sametgul/roman3d/docs/embedded_sw.md

# Roman3D: Embedded Software

## Overview

We used STM32CubeIDE to develop the embedded software. Here is Pinout View of the MCU.

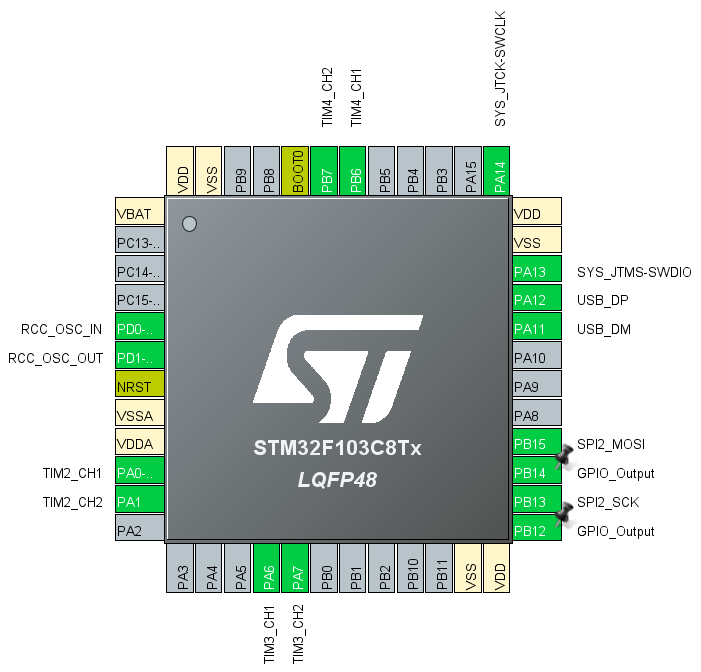
[picture p3: figs/pinoutstm32.png]
template


In pinout & configuration window, make sure you chose the following settings.

System Core -> GPIO

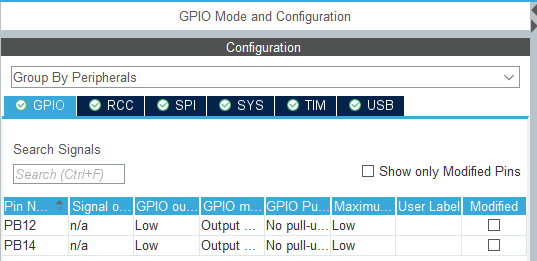
[picture p4: figs/gpiocube.png]
gpio


System Core -> RCC

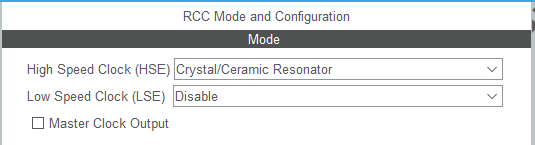
[picture p5: figs/rcccube.png]
rcc


System Core -> SYS

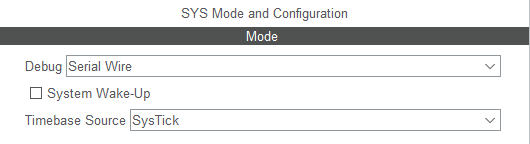
[picture p6: figs/syscube.png]
sys


We use Timers for Encoder reading. Timers -> TIM2, TIM3, TIM4

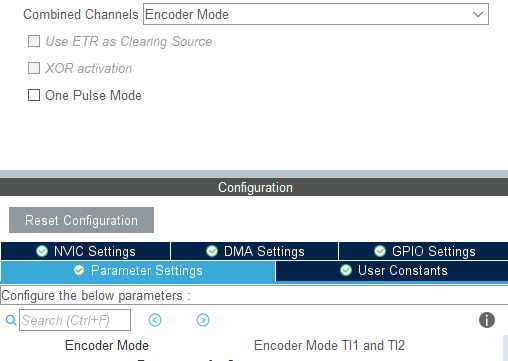
[picture p7: figs/tim234cube.png]
tim234


The SPI settings (Data Size and First Bit) chosen according to DAC chips datasheet. 

Connectivity -> SPI2

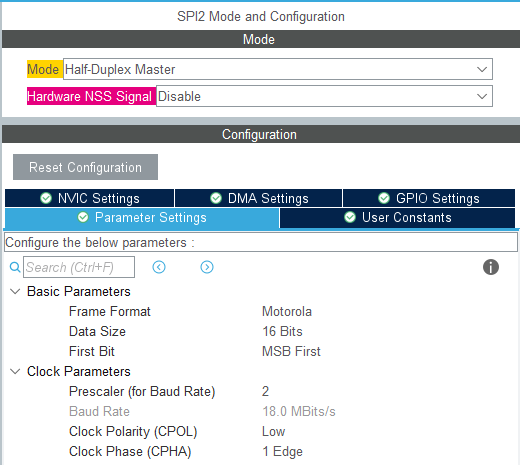
[picture p8: figs/spi2cube.png]
spi2


Connectivity -> USB

USB

Middleware -> USB_DEVICE

USB Dev

Here is Clock Configurtion

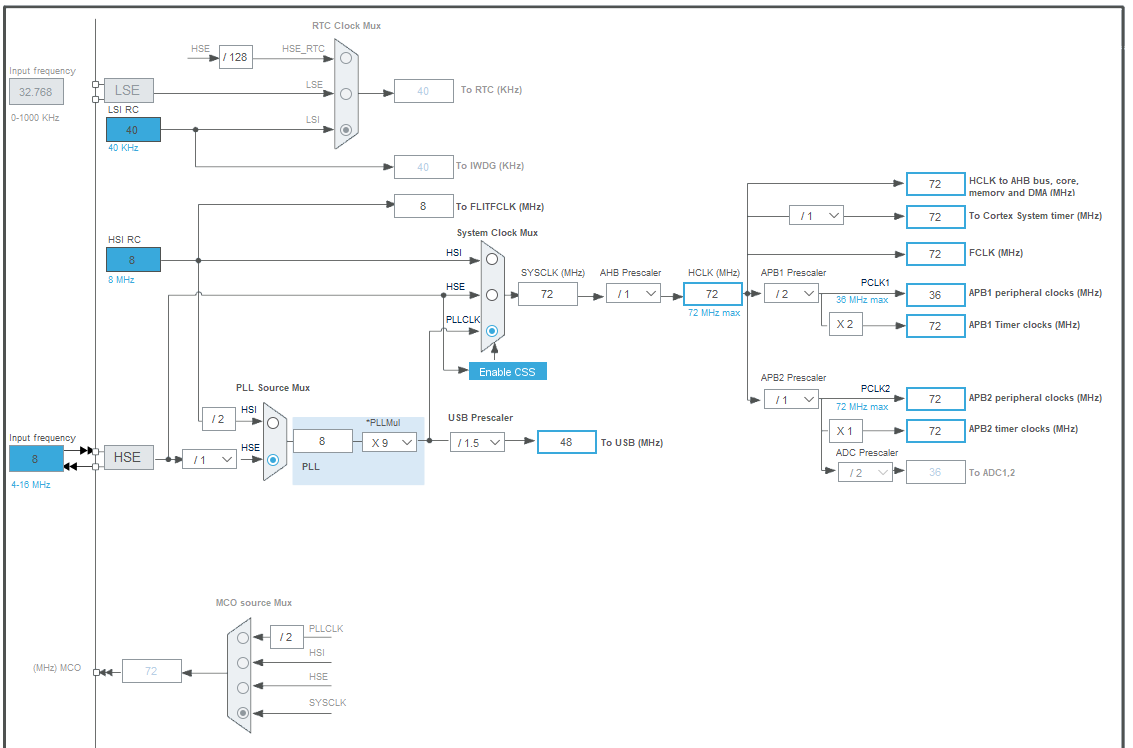
[picture p9: figs/clockcube.png]
Clock Config
