sametgul/roman3d/CAD model/link3 coupling project/enc_part-Body.stl

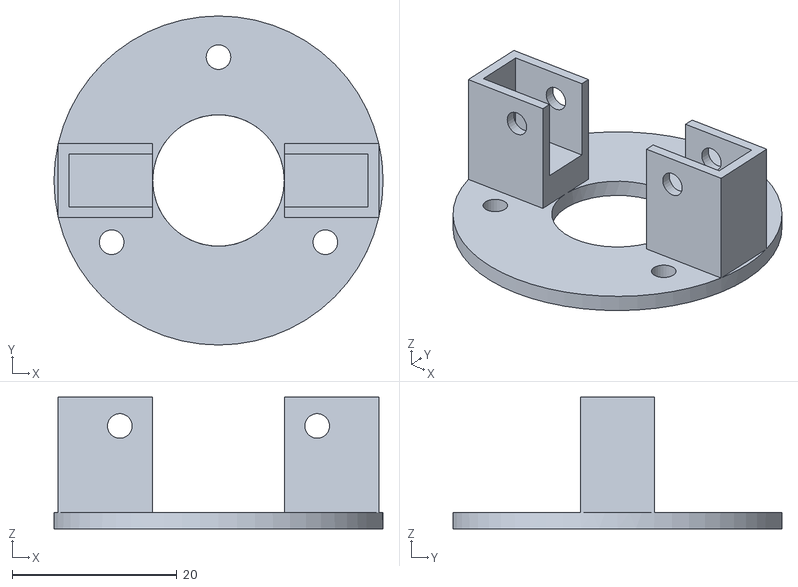
[picture p10: CAD file, 2023-09-05]
CAD model/link3 coupling project/enc_part-Body.stl
40.0 x 40.0 x 16.0
