sametgul/roman3d/CAD model/manipulator project/project.FCStd

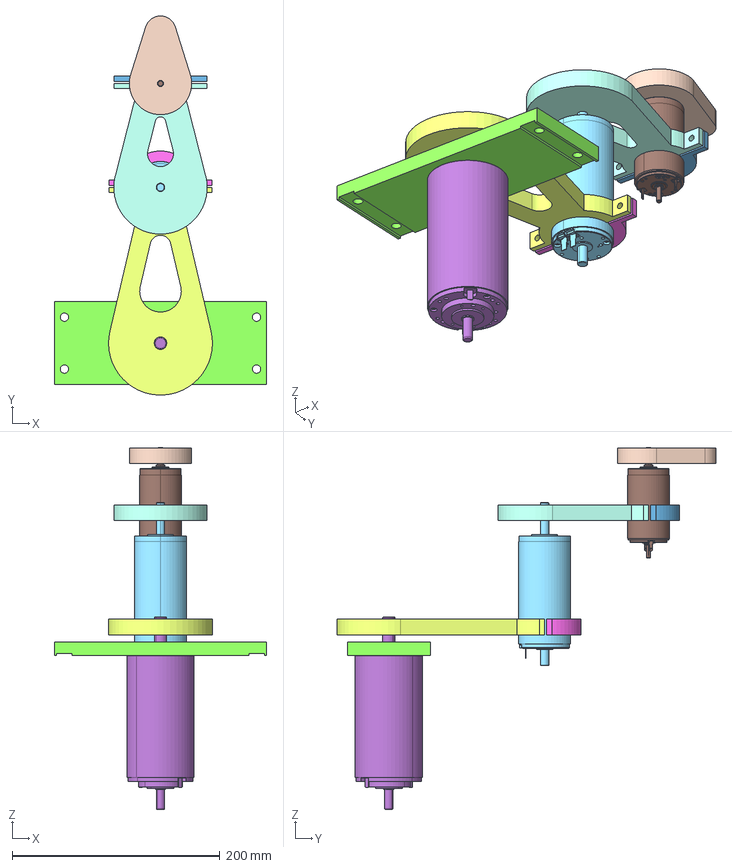
[picture p11: CAD file, 2023-09-05]
CAD model/manipulator project/project.FCStd
204.4 x 364.9 x 348.7 mm
353294_RE65_GB_250W_KL_2WE
Link1
370354_RE50_GB_200W_KL_2WE
Link2
148866_SW0001
Link3
Base
Link1_Cap
Link2_Cap
