sametgul/roman3d/CAD model/step files/link3_v2.step

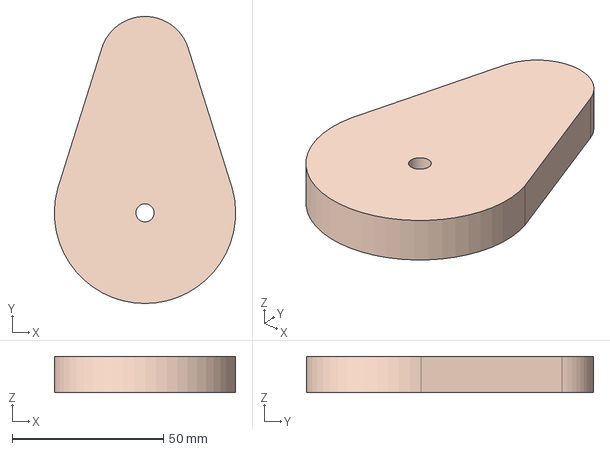
[picture p12: CAD file, 2023-09-05]
CAD model/step files/link3_v2.step
60.0 x 95.0 x 12.0 mm
