sametgul/roman3d/CAD model/link3 coupling project/motor_part_v2-Body.stl

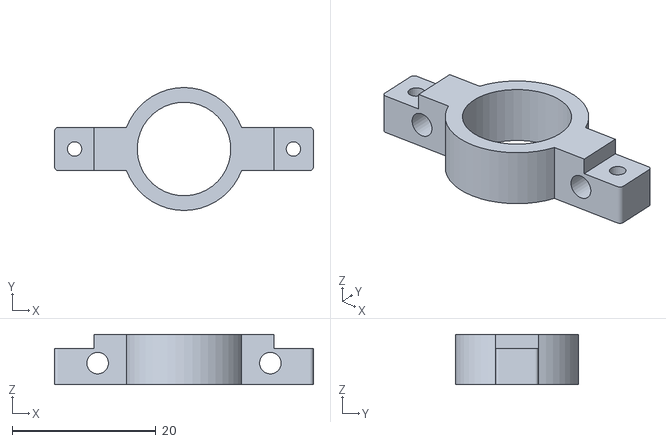
[picture p13: CAD file, 2023-09-05]
CAD model/link3 coupling project/motor_part_v2-Body.stl
36.0 x 17.1 x 7.00
