sametgul/roman3d/CAD model/step files/link1_cap_v2.step

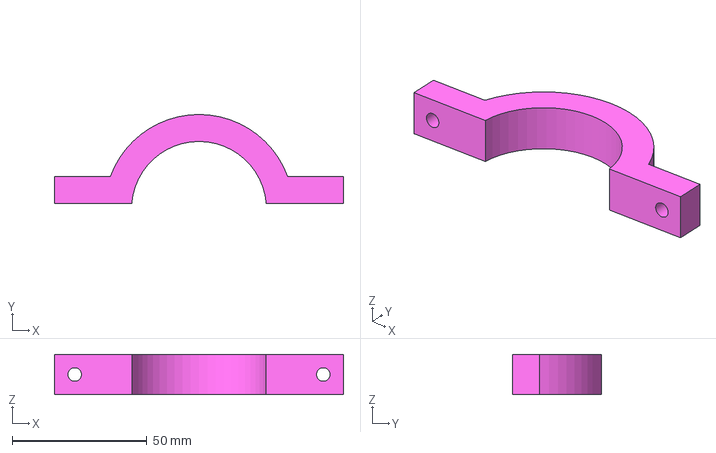
[picture p14: CAD file, 2023-09-05]
CAD model/step files/link1_cap_v2.step
107.1 x 33.0 x 15.0 mm
