sametgul/roman3d/CAD model/step files/link2_cap_v2.step

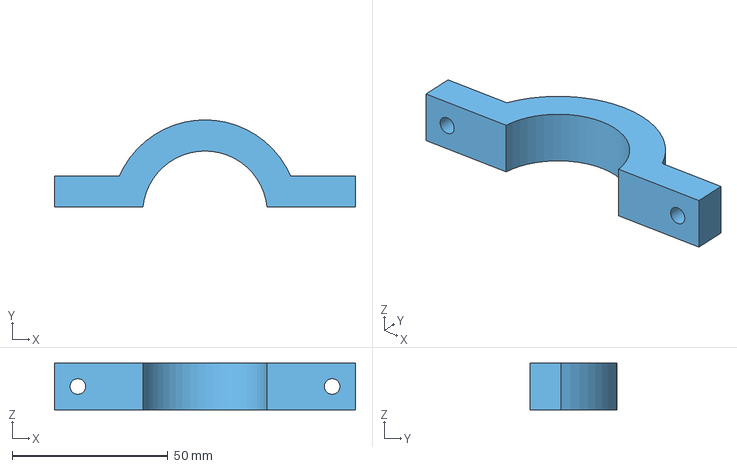
[picture p15: CAD file, 2023-09-05]
CAD model/step files/link2_cap_v2.step
96.6 x 28.0 x 15.0 mm
