sametgul/roman3d/CAD model/step files/link2_v2.step

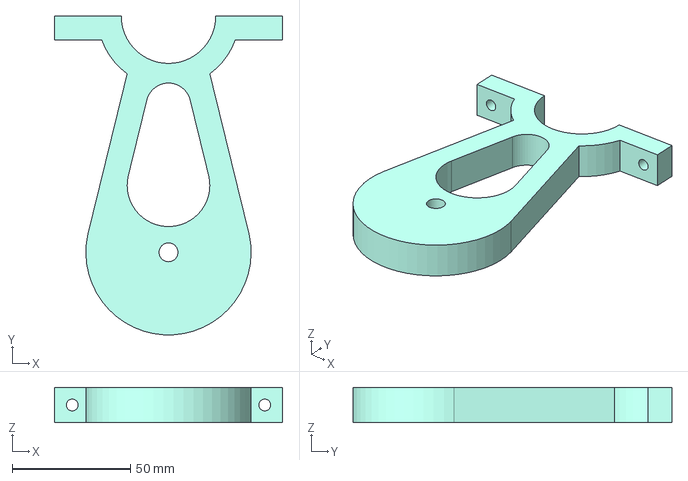
[picture p16: CAD file, 2023-09-05]
CAD model/step files/link2_v2.step
96.6 x 134.9 x 15.0 mm
