sametgul/roman3d/CAD model/step files/base_v2.step

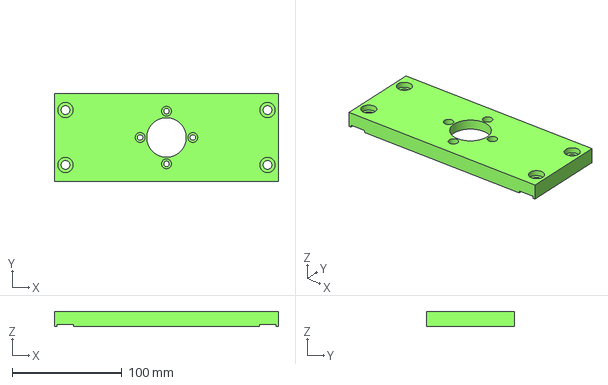
[picture p17: CAD file, 2023-09-05]
CAD model/step files/base_v2.step
204.0 x 80.0 x 14.0 mm
