sametgul/roman3d/CAD model/step files/link1_v2.step

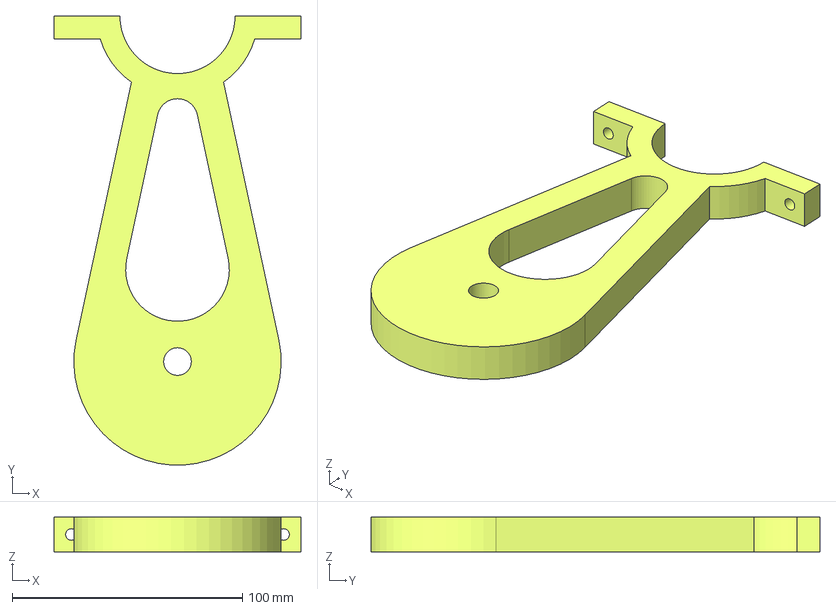
[picture p18: CAD file, 2023-09-05]
CAD model/step files/link1_v2.step
107.1 x 194.9 x 15.0 mm
