sametgul/roman3d/CAD model/1st motor/353294_RE65_GB_250W_KL_2WE.stp

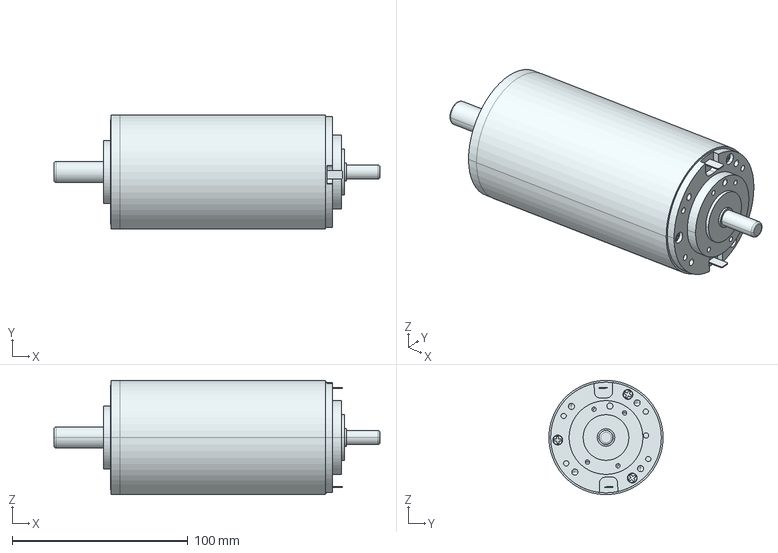
[picture p19: CAD file, 2023-09-05]
CAD model/1st motor/353294_RE65_GB_250W_KL_2WE.stp
185.5 x 65.0 x 65.0 mm
