sametgul/roman3d/CAD model/2nd motor/370354_RE50_GB_200W_KL_2WE.stp

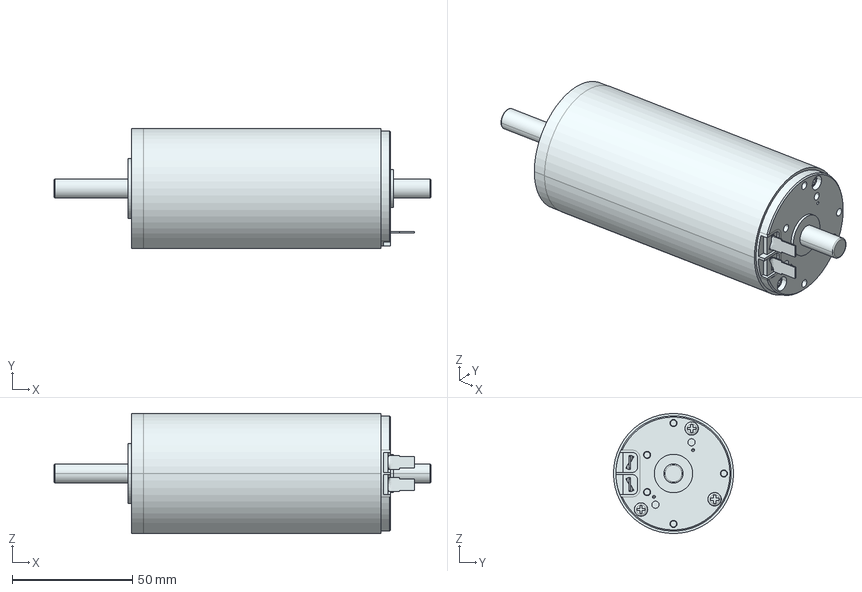
[picture p20: CAD file, 2023-09-05]
CAD model/2nd motor/370354_RE50_GB_200W_KL_2WE.stp
157.0 x 50.0 x 50.0 mm
