sametgul/roman3d/CAD model/3rd motor/148866_RE40_GB_150W_KL_2WE.stp

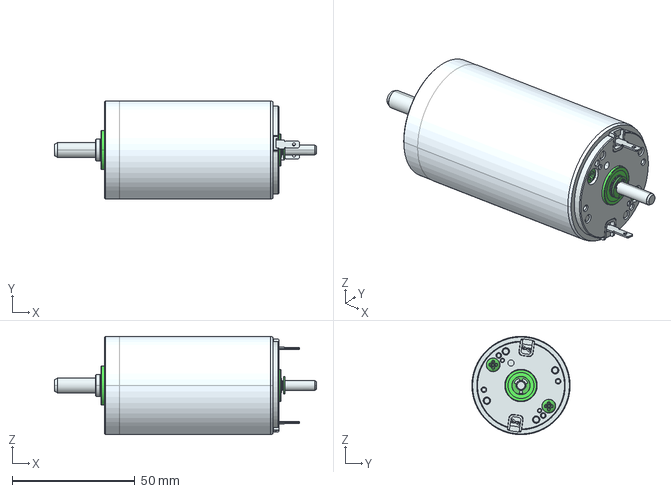
[picture p21: CAD file, 2023-09-05]
CAD model/3rd motor/148866_RE40_GB_150W_KL_2WE.stp
106.6 x 40.0 x 40.0 mm
