sametgul/roman3d/(list of files, cad)

Other CAD files:
CAD model/link3 coupling project/motor_part_v2.FCStd
CAD model/link3 coupling project/enc_part.FCStd
