sametgul/roman3d/circuit_design/schematic.pdf

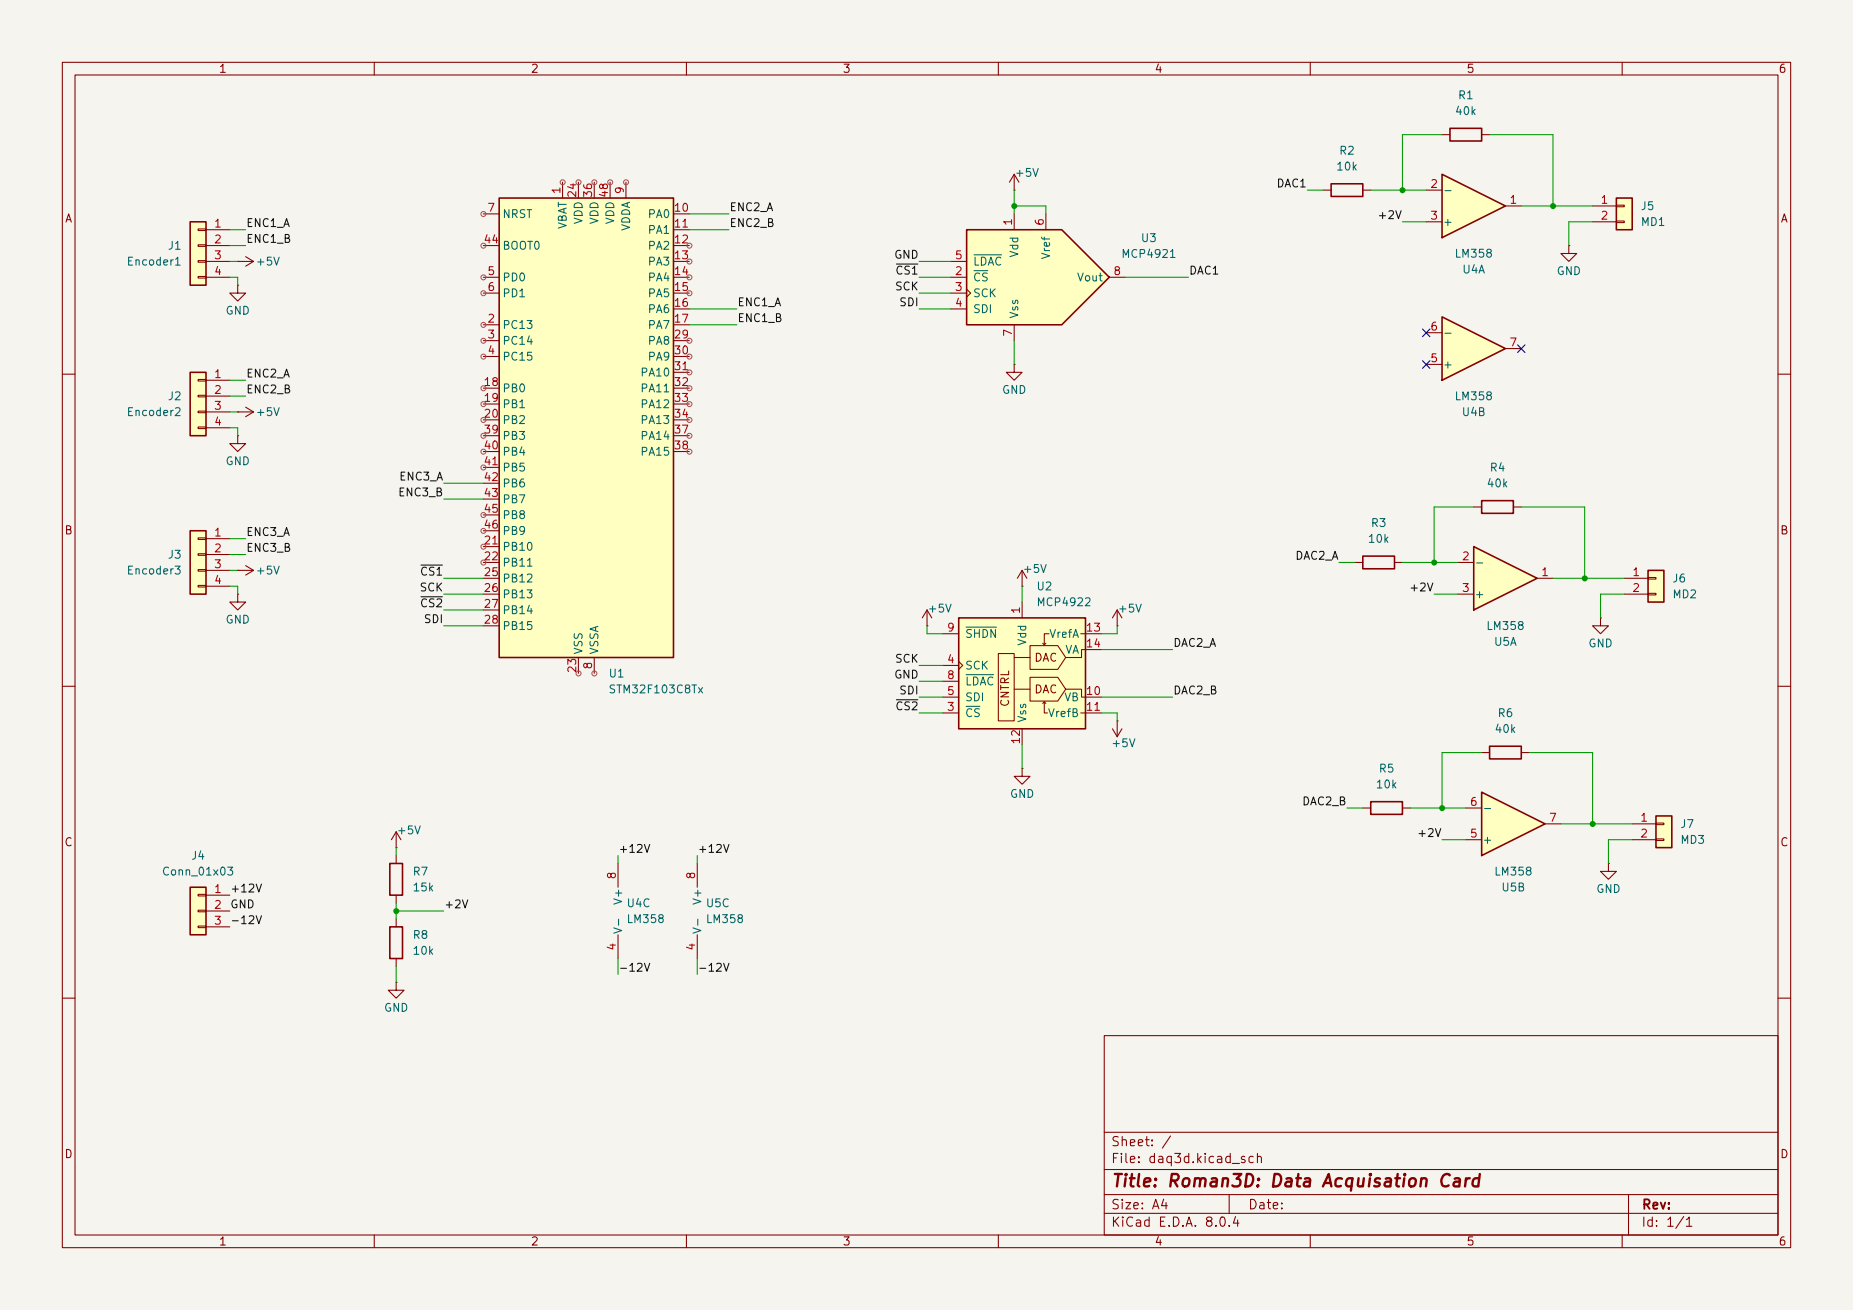
[picture p22: page 1]
