sametgul/roman3d/circuit_design/schematics2.pdf

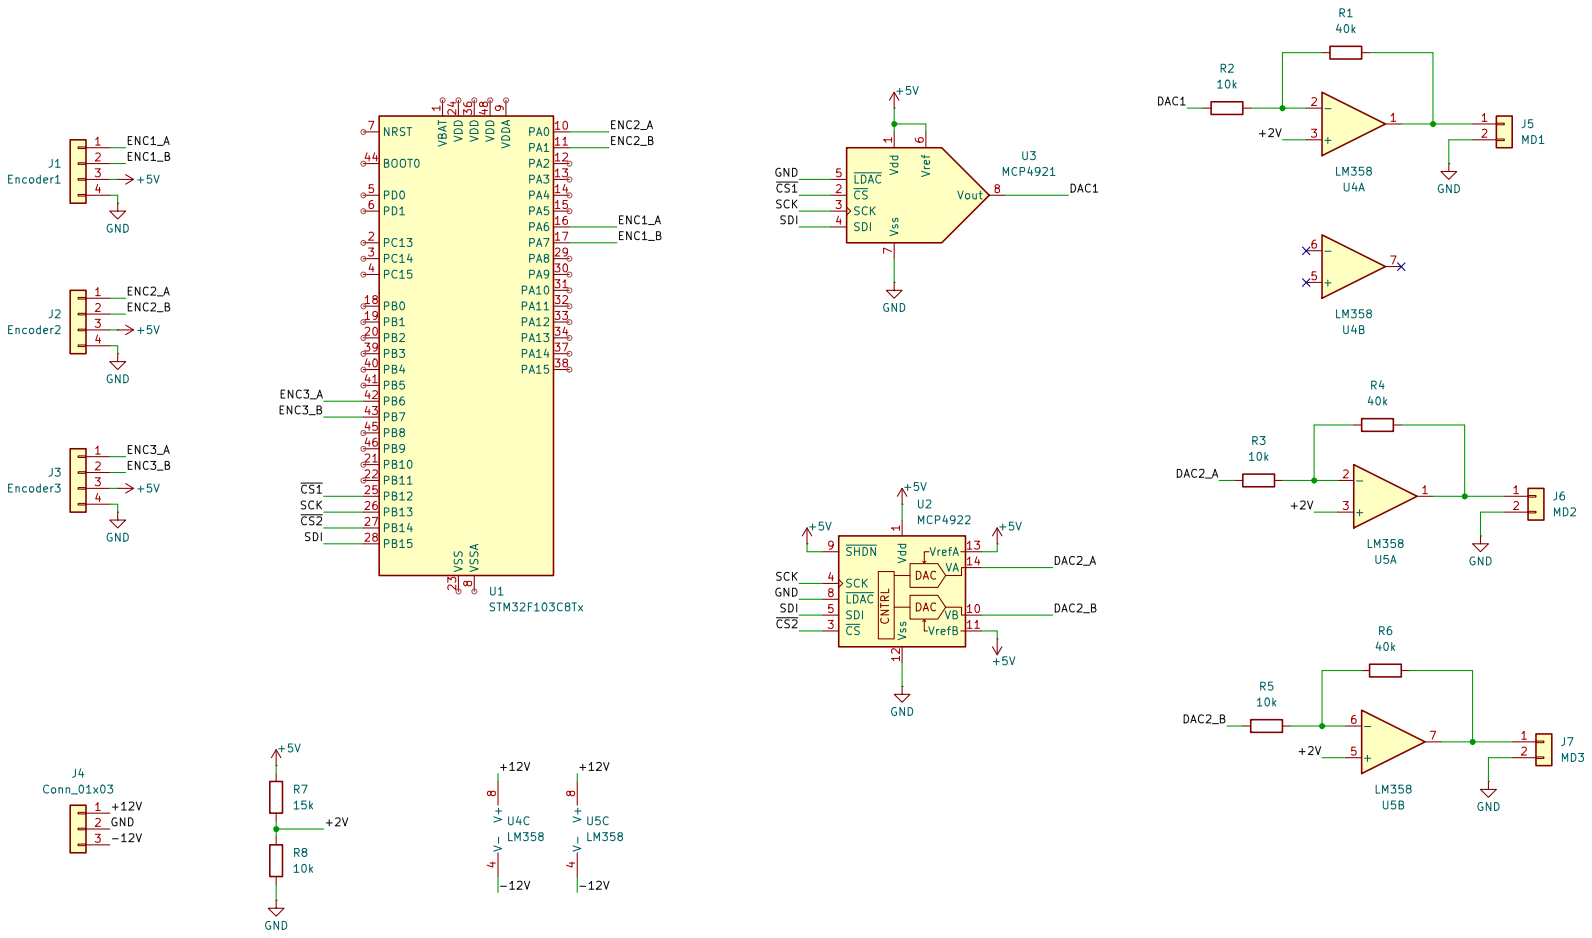
[picture p23: page 1]
