sametgul/roman3d/circuit_design/daq3d.kicad_sch

## KiCad design circuit_design/daq3d.kicad_sch (2024-09-04)

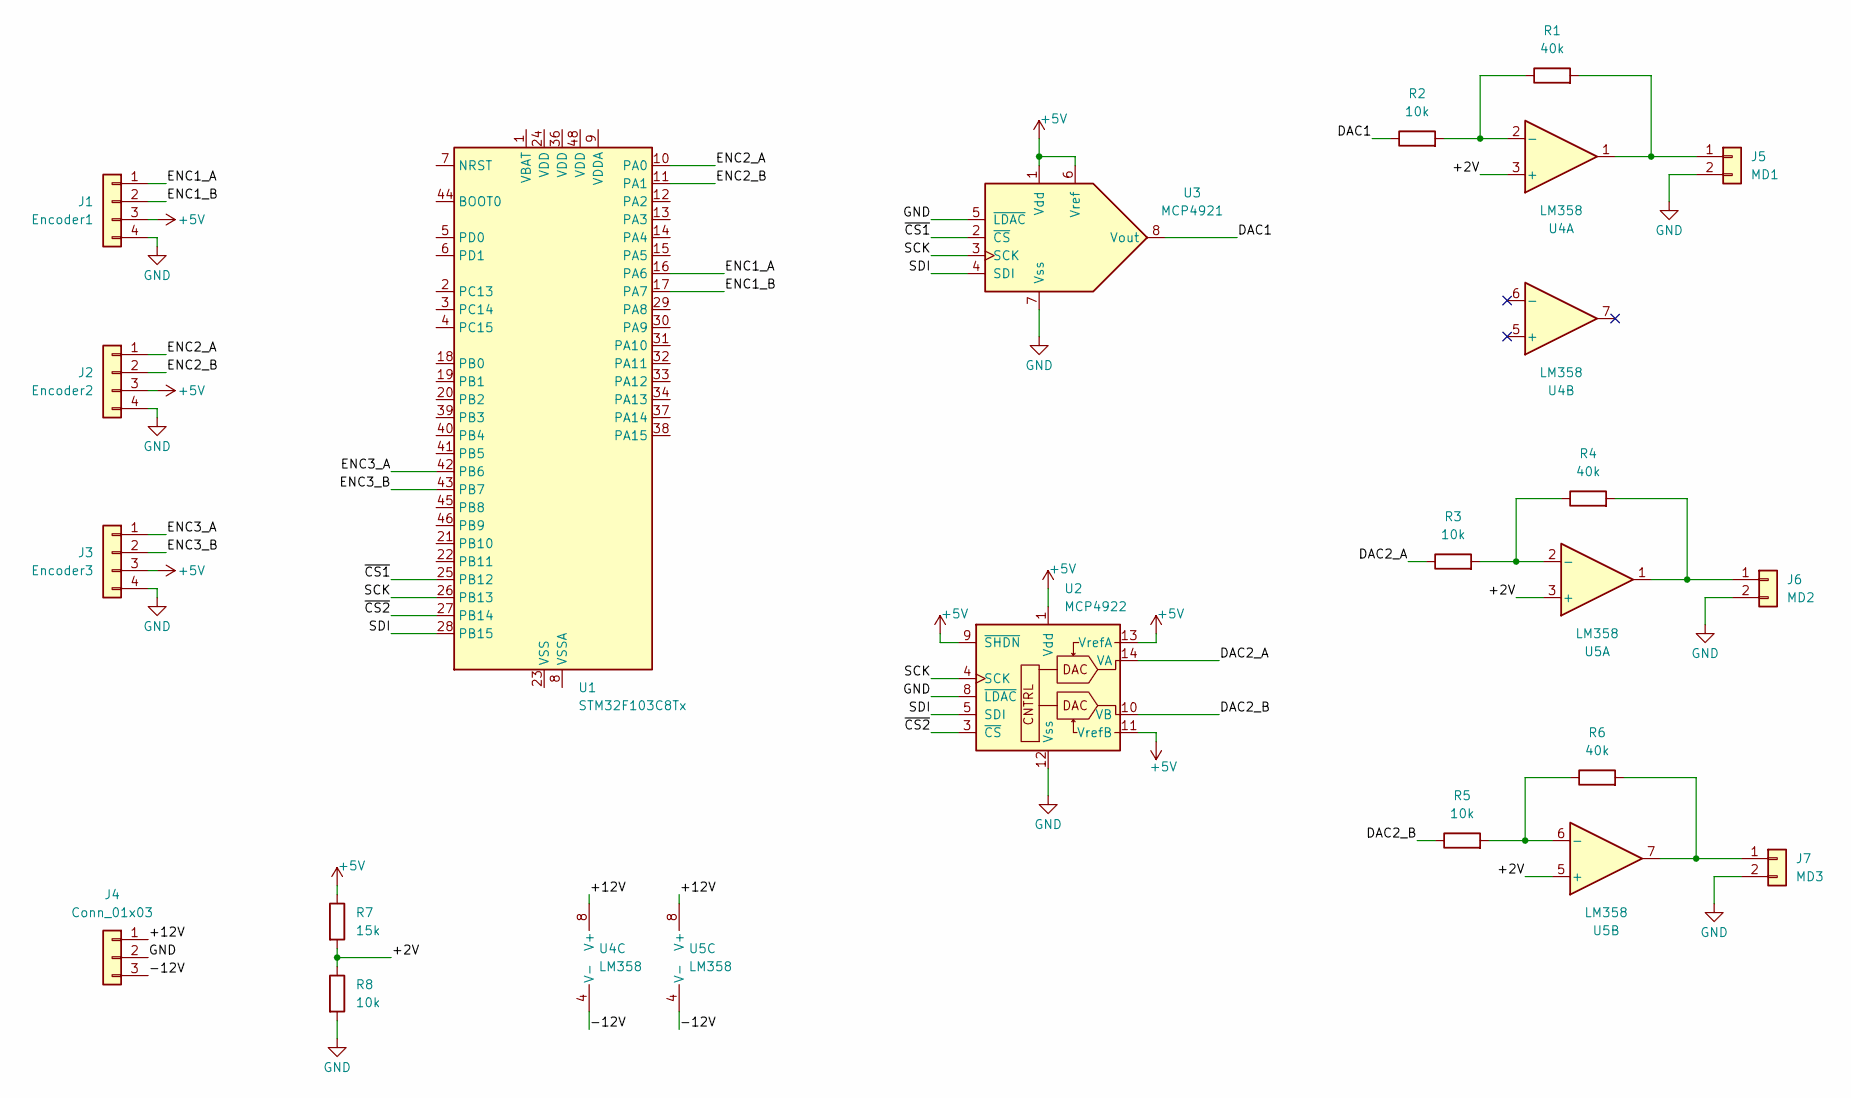
[picture p24: schematic daq3d.kicad_sch]

Parts:
J1: Encoder1
J2: Encoder2
J3: Encoder3
J4: Conn_01x03
J5: MD1
J6: MD2
J7: MD3
R1, R4, R6: 40k
R2, R3, R5, R8: 10k
R7: 15k
U1: STM32F103C8Tx; LQFP-48_7x7mm_P0.5mm
U2: MCP4922
U3: MCP4921
U4, U5: LM358

Connections:
+2V: R7.2, R8.1, U4.3 (+), U5.3 (+), U5.5 (+)
+5V: J1.3, J2.3, J3.3, R7.1, U2.1 (Vdd), U2.9 (~SHDN), U2.11 (VrefB), U2.13 (VrefA), U3.1 (Vdd), U3.6 (Vref)
+12V: J4.1, U4.8 (V+), U5.8 (V+)
-12V: J4.3, U4.4 (V-), U5.4 (V-)
DAC1: R2.1, U3.8 (Vout)
DAC2_A: R3.1, U2.14 (VA)
DAC2_B: R5.1, U2.10 (VB)
ENC1_A: J1.1, U1.16 (PA6)
ENC1_B: J1.2, U1.17 (PA7)
ENC2_A: J2.1, U1.10 (PA0)
ENC2_B: J2.2, U1.11 (PA1)
ENC3_A: J3.1, U1.42 (PB6)
ENC3_B: J3.2, U1.43 (PB7)
GND: J1.4, J2.4, J3.4, J4.2, J5.2, J6.2, J7.2, R8.2, U2.8 (~LDAC), U2.12 (Vss), U3.5 (~LDAC), U3.7 (Vss)
unnamed: J5.1, R1.2, U4.1
unnamed: J6.1, R4.2, U5.1
unnamed: J7.1, R6.2, U5.7
unnamed: R1.1, R2.2, U4.2 (-)
unnamed: R3.2, R4.1, U5.2 (-)
unnamed: R5.2, R6.1, U5.6 (-)
unnamed: U1.23 (VSS), U1.35 (VSS), U1.47 (VSS)
SCK: U1.26 (PB13), U2.4 (SCK), U3.3 (SCK)
SDI: U1.28 (PB15), U2.5 (SDI), U3.4 (SDI)
~CS1: U1.25 (PB12), U3.2 (~CS)
~CS2: U1.27 (PB14), U2.3 (~CS)
