sametgul/roman3d/embedded_software/Core/Src/main.c

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
/* Includes ------------------------------------------------------------------*/
#include "main.h"
#include "usb_device.h"

/* USER CODE BEGIN Includes */

#include "usbd_cdc_if.h"

/* USER CODE END Includes */

SPI_HandleTypeDef hspi2;

TIM_HandleTypeDef htim2;
TIM_HandleTypeDef htim3;
TIM_HandleTypeDef htim4;

/* USER CODE BEGIN PV */

int16_t encoder_value[3];

uint8_t received_data[6];
uint16_t dac_value_12bit[3];
uint16_t dac_command;

uint8_t flag=0;

uint32_t last_time;



/* USER CODE END PV */

void SystemClock_Config(void);
static void MX_GPIO_Init(void);
static void MX_SPI2_Init(void);
static void MX_TIM2_Init(void);
static void MX_TIM3_Init(void);
static void MX_TIM4_Init(void);
/* USER CODE BEGIN 0 */

// This function creates the needed command to send DAC chips
// The least 12 bits of value variable is evaluated, thus, assign 12 bit values to this variable.
uint16_t create_DAC_cmd(uint16_t value, uint8_t dac_ch)
{
	uint16_t data = 0;

	value = 4095 - value;

	data |= (dac_ch << 15); 	// If dac_ch is 0, then DAC_A, and if dac_ch is 1, DAC_B will be selected.
	data |= (0      << 14); 	// V_ref Input Buffer = Unbuffered
	data |= (1      << 13); 	// Output Gain is 1
	data |= (1      << 12);     // Active mode operation
	data |= (value & 0x0FFF);	// 12 bit of value assigned to data

	return data;
}

/* USER CODE END 0 */

/**
  * @brief  The application entry point.
  * @retval int
  */
int main(void)
{
  /* MCU Configuration--------------------------------------------------------*/

  /* Reset of all peripherals, Initializes the Flash interface and the Systick. */
  HAL_Init();

  /* Configure the system clock */
  SystemClock_Config();

  /* Initialize all configured peripherals */
  MX_GPIO_Init();
  MX_SPI2_Init();
  MX_TIM2_Init();
  MX_TIM3_Init();
  MX_TIM4_Init();
  MX_USB_DEVICE_Init();
  /* USER CODE BEGIN 2 */

	// Encoder Initialization
	HAL_TIM_Encoder_Start(&htim2, TIM_CHANNEL_ALL);
	HAL_TIM_Encoder_Start(&htim3, TIM_CHANNEL_ALL);
	HAL_TIM_Encoder_Start(&htim4, TIM_CHANNEL_ALL);

	// SPI Initialization
	HAL_GPIO_WritePin(GPIOB, GPIO_PIN_12 | GPIO_PIN_14, GPIO_PIN_SET); // Chip selects are set HIGH


  /* USER CODE END 2 */

  /* Infinite loop */
  /* USER CODE BEGIN WHILE */
  while (1)
  {
		if (flag == 1) {

			///////////////////////////////WRITE to DAC///////////////////////////////////
			// Reading 12-bit DAC values from MATLAB
			dac_value_12bit[0] = (received_data[0] | (received_data[1] << 8));
			dac_value_12bit[1] = (received_data[2] | (received_data[3] << 8));
			dac_value_12bit[2] = (received_data[4] | (received_data[5] << 8));

			// Writing to MCP4921
			dac_command = create_DAC_cmd(dac_value_12bit[0], 0);

			HAL_GPIO_WritePin(GPIOB, GPIO_PIN_12, GPIO_PIN_RESET);
			HAL_SPI_Transmit(&hspi2, (uint8_t *) &dac_command, 1, 100);
			HAL_GPIO_WritePin(GPIOB, GPIO_PIN_12, GPIO_PIN_SET);

			// Writing to MCP4922 A Channel
			dac_command = create_DAC_cmd(dac_value_12bit[1], 0);

			HAL_GPIO_WritePin(GPIOB, GPIO_PIN_14, GPIO_PIN_RESET);
			HAL_SPI_Transmit(&hspi2, (uint8_t *) &dac_command, 1, 100);
			HAL_GPIO_WritePin(GPIOB, GPIO_PIN_14, GPIO_PIN_SET);

			// Writing to MCP4922 B Channel
			dac_command = create_DAC_cmd(dac_value_12bit[2], 1);

			HAL_GPIO_WritePin(GPIOB, GPIO_PIN_14, GPIO_PIN_RESET);
			HAL_SPI_Transmit(&hspi2, (uint8_t *) &dac_command, 1, 100);
			HAL_GPIO_WritePin(GPIOB, GPIO_PIN_14, GPIO_PIN_SET);

			///////////////////////////////READ ENCODERS//////////////////////////////////
			// Reading encoder values from manipulator
			encoder_value[0] = __HAL_TIM_GET_COUNTER(&htim3);
			encoder_value[1] = __HAL_TIM_GET_COUNTER(&htim2);
			encoder_value[2] = __HAL_TIM_GET_COUNTER(&htim4);

			// Sending the read encoder values to MATLAB
			CDC_Transmit_FS((uint8_t*) &encoder_value, 6);

			flag = 0;

			last_time = HAL_GetTick();

		}

		//if 200ms no data is incoming, then make the outputs 0V
		//sending to DAC 2047 value = sending 0V to the motors
		else if(((last_time+200) < HAL_GetTick()) && (flag == 0)){

			dac_value_12bit[0] = 2047;
			dac_value_12bit[1] = 2047;
			dac_value_12bit[2] = 2047;

			// Writing to MCP4921
			dac_command = create_DAC_cmd(dac_value_12bit[0], 0);

			HAL_GPIO_WritePin(GPIOB, GPIO_PIN_12, GPIO_PIN_RESET);
			HAL_SPI_Transmit(&hspi2, (uint8_t *) &dac_command, 1, 100);
			HAL_GPIO_WritePin(GPIOB, GPIO_PIN_12, GPIO_PIN_SET);

			// Writing to MCP4922 A Channel
			dac_command = create_DAC_cmd(dac_value_12bit[1], 0);

			HAL_GPIO_WritePin(GPIOB, GPIO_PIN_14, GPIO_PIN_RESET);
			HAL_SPI_Transmit(&hspi2, (uint8_t *) &dac_command, 1, 100);
			HAL_GPIO_WritePin(GPIOB, GPIO_PIN_14, GPIO_PIN_SET);

			// Writing to MCP4922 B Channel
			dac_command = create_DAC_cmd(dac_value_12bit[2], 1);

			HAL_GPIO_WritePin(GPIOB, GPIO_PIN_14, GPIO_PIN_RESET);
			HAL_SPI_Transmit(&hspi2, (uint8_t *) &dac_command, 1, 100);
			HAL_GPIO_WritePin(GPIOB, GPIO_PIN_14, GPIO_PIN_SET);

			// Resetting Encoder counters
			__HAL_TIM_SET_COUNTER(&htim3, 0);
			__HAL_TIM_SET_COUNTER(&htim2, 0);
			__HAL_TIM_SET_COUNTER(&htim4, 0);

		}

    /* USER CODE END WHILE */

    /* USER CODE BEGIN 3 */
  }
  /* USER CODE END 3 */
}

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
