sametgul/roman3d/(commit log)

2023-09-05 CAD models of the manipulator added
    [148866_RE40_GB_150W_KL_2WE.stp, 353294_RE65_GB_250W_KL_2WE.stp, 370354_RE50_GB_200W_KL_2WE.stp, base_v2.step, enc_part-Body.stl, enc_part.FCStd, link properties.xlsx, link1_cap_v2.step]
2024-05-30 new commit
    [link properties.xlsx]
2024-09-04 Circuit design has been added
    [daq3d.kicad_pcb, daq3d.kicad_sch]
